PhelanDev/PHELAN_butterfly/Source code/wirring.jpg

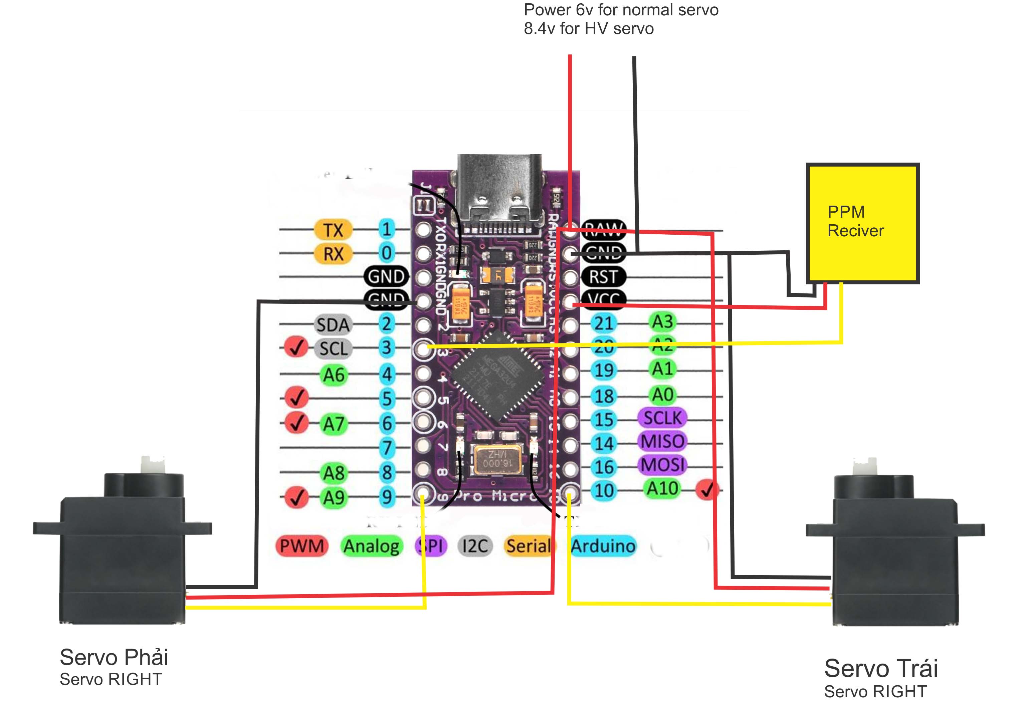
Source code/wirring.jpg
