PhelanDev/PHELAN_butterfly/sodomach/sodomach.png

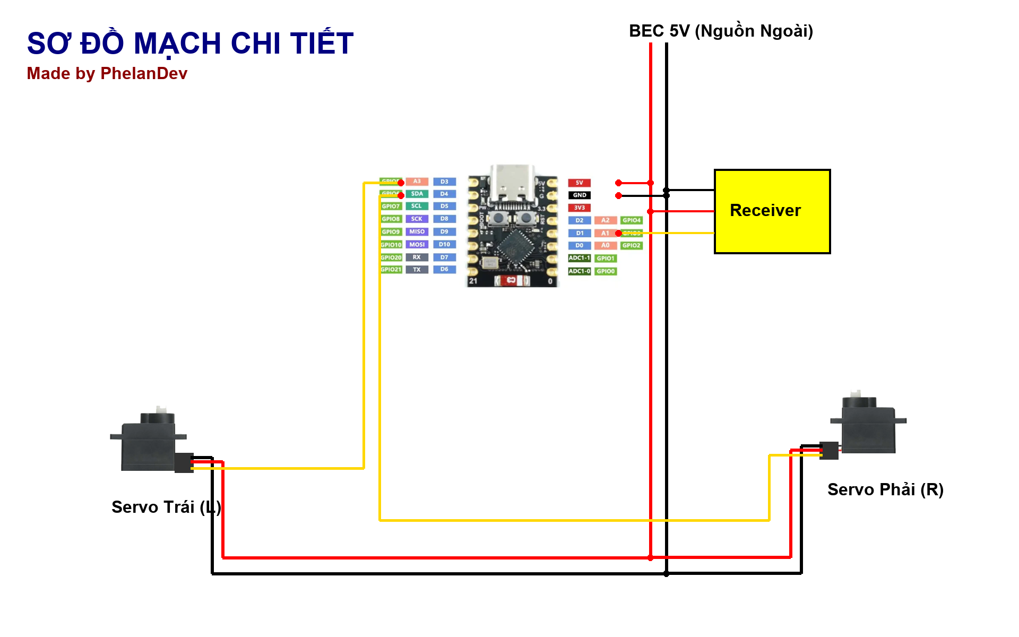
sodomach/sodomach.png
