PhelanDev/PHELAN_butterfly/Templates_ Cutting files/laser_cut_Main_fram_S_DiY_RC_bionic_butterfly.dxf

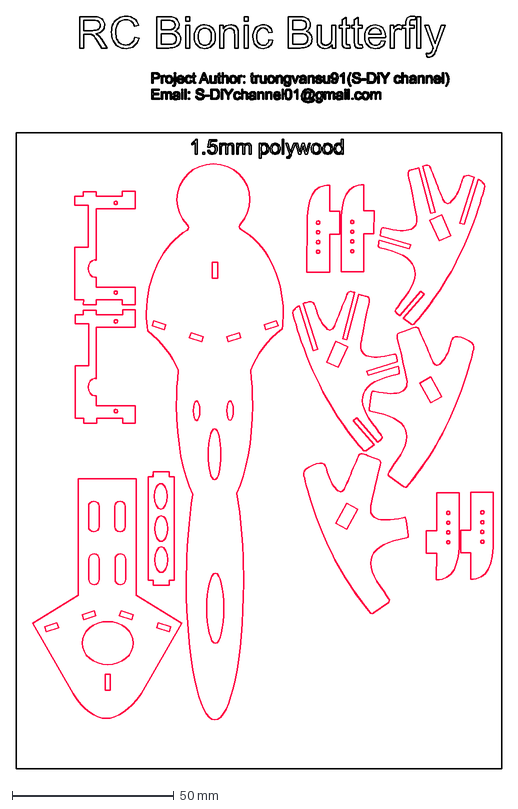
[picture p3: CAD file, 2026-07-16]
Templates_ Cutting files/laser_cut_Main_fram_S_DiY_RC_bionic_butterfly.dxf
150.3 x 232.9 mm
