PhelanDev/PHELAN_butterfly/khungcanh/01_Than_Chinh_Main_Body_Slim_Fillet.step

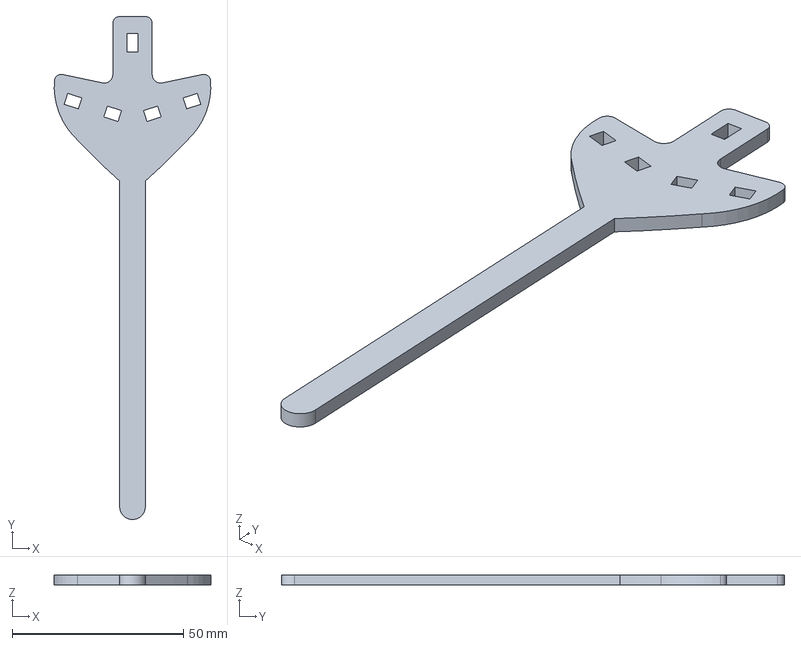
[picture p4: CAD file, 2026-09-27]
khungcanh/01_Than_Chinh_Main_Body_Slim_Fillet.step
45.7 x 146.8 x 3.00 mm
