PhelanDev/PHELAN_butterfly/khungcanh/Dimension_Main_fram.3d.dxf

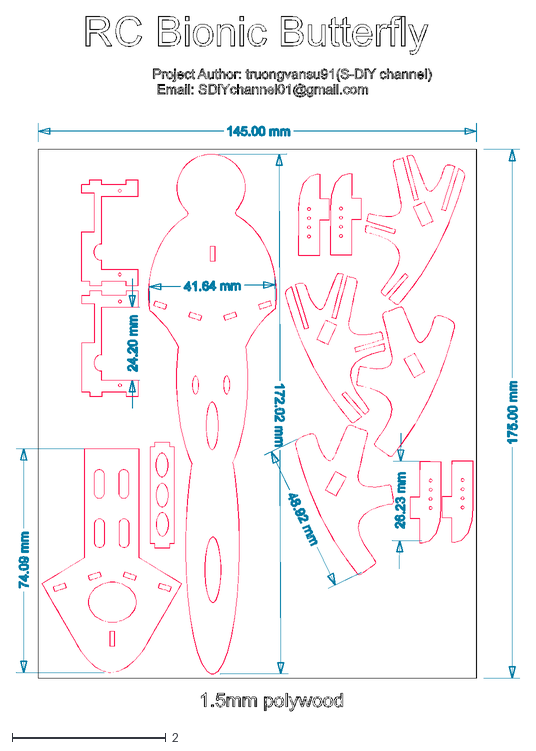
[picture p5: CAD file, 2026-09-27]
khungcanh/Dimension_Main_fram.3d.dxf
6.56 x 9.06
