PhelanDev/PHELAN_butterfly/khungcanh/04_Khung_Servo_Trai_PTK7452.step

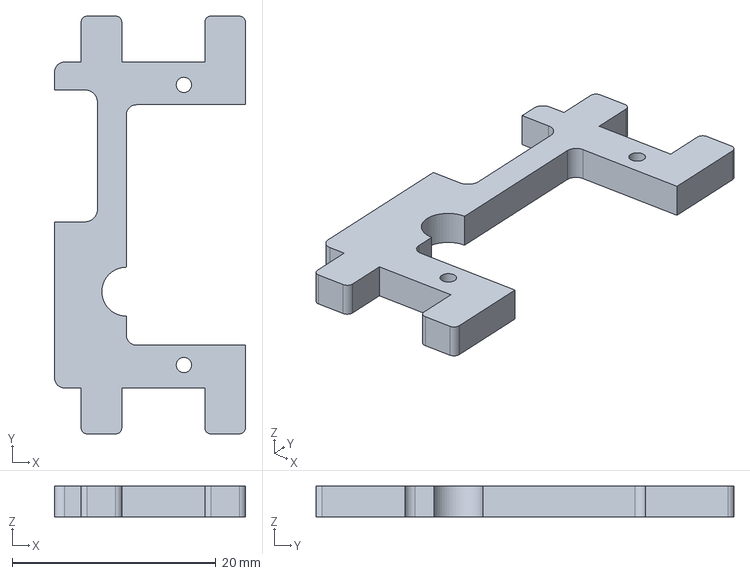
[picture p6: CAD file, 2026-09-27]
khungcanh/04_Khung_Servo_Trai_PTK7452.step
18.8 x 41.0 x 3.00 mm
