PhelanDev/PHELAN_butterfly/khungcanhmach/00_ALL_PARTS_FLAT_KHUNG_FELET-2.0.step

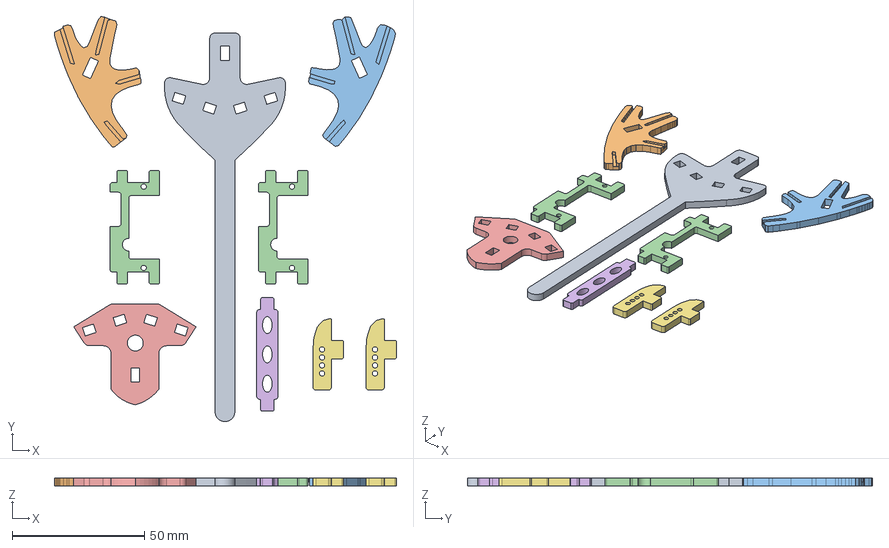
[picture p7: CAD file, 2026-10-04]
khungcanhmach/00_ALL_PARTS_FLAT_KHUNG_FELET-2.0.step
129.1 x 153.0 x 3.00 mm
