PhelanDev/PHELAN_butterfly/thanV3/01_Than_Lien_Khoi_Bionic_Pod_ESP32_C3_SuperMini_RealFit.step

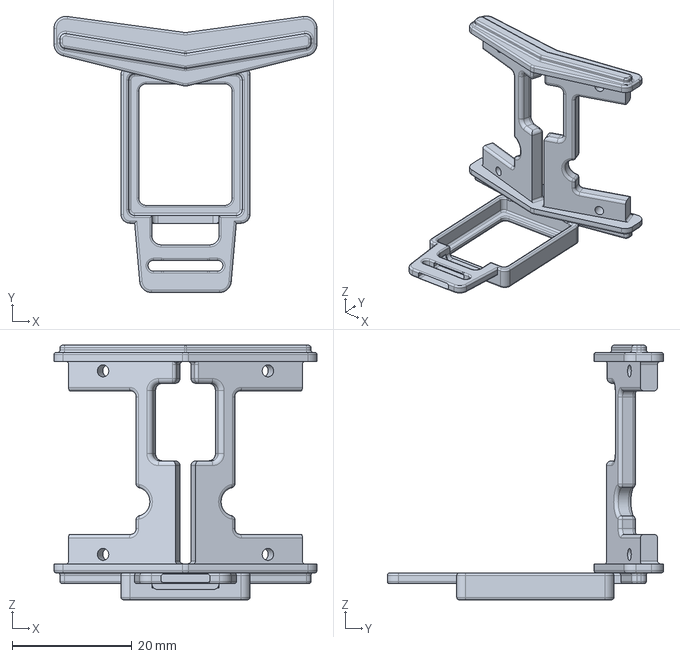
[picture p8: CAD file, 2026-10-15]
thanV3/01_Than_Lien_Khoi_Bionic_Pod_ESP32_C3_SuperMini_RealFit.step
44.0 x 46.2 x 42.6 mm
