PhelanDev/PHELAN_butterfly/khungcanh/08_Ban_Le_Truc_Xoay_x1.step

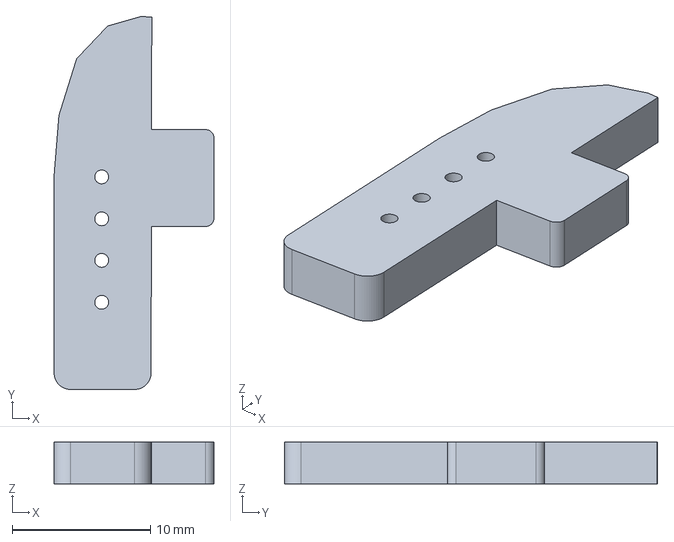
[picture p9: CAD file, 2026-09-27]
khungcanh/08_Ban_Le_Truc_Xoay_x1.step
11.5 x 26.9 x 3.00 mm
