PhelanDev/PHELAN_butterfly/khungcanhmach/03_Thanh_Giang_Bung_Center_Rib.step

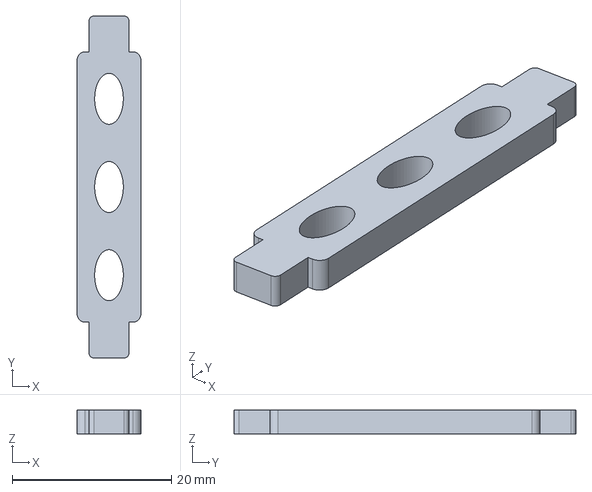
[picture p10: CAD file, 2026-10-04]
khungcanhmach/03_Thanh_Giang_Bung_Center_Rib.step
8.00 x 42.9 x 3.00 mm
