PhelanDev/PHELAN_butterfly/thanV3/01_Than_Lien_Khoi_Bionic_Pod_ESP32_BatteryRail.step

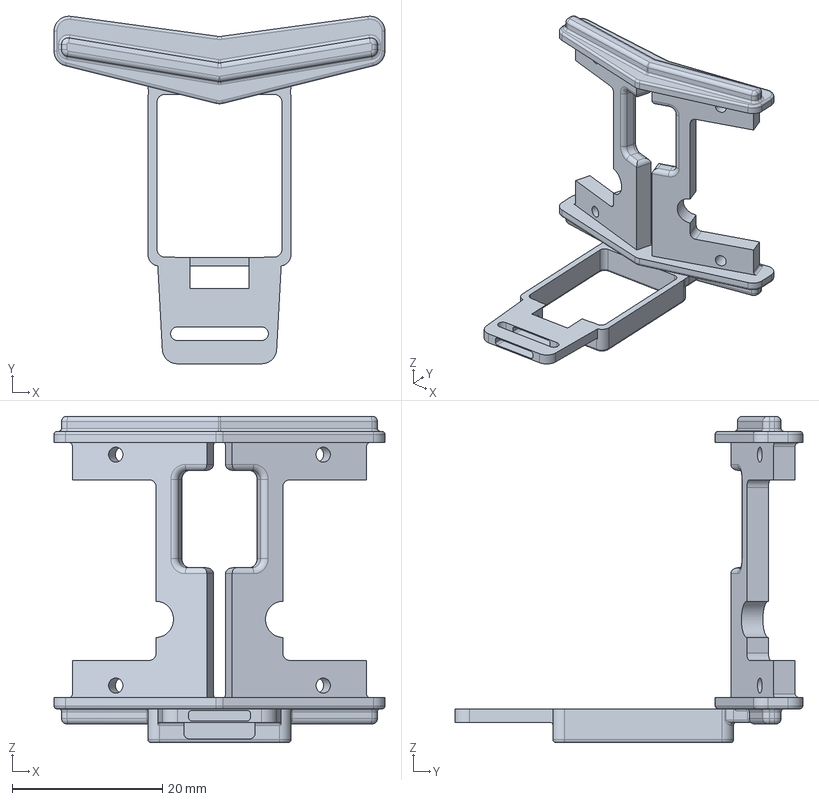
[picture p11: CAD file, 2026-10-15]
thanV3/01_Than_Lien_Khoi_Bionic_Pod_ESP32_BatteryRail.step
44.0 x 46.2 x 43.4 mm
