PhelanDev/PHELAN_butterfly/khungcanh/03_Thanh_Giang_Bung_Center_Rib.step

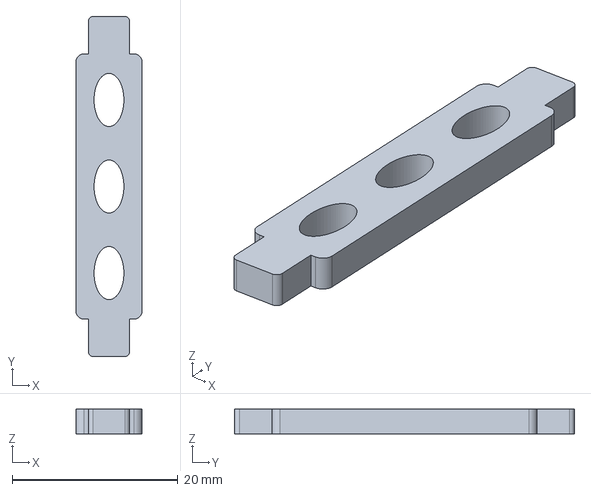
[picture p12: CAD file, 2026-09-27]
khungcanh/03_Thanh_Giang_Bung_Center_Rib.step
8.00 x 41.0 x 3.00 mm
