PhelanDev/PHELAN_butterfly/khungcanhmach/RC_Butterfly_All_Parts_Flat_PTK7452_PETG_3mm.step

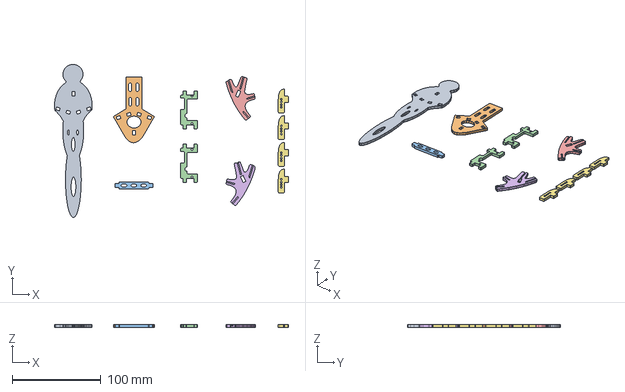
[picture p13: CAD file, 2026-10-04]
khungcanhmach/RC_Butterfly_All_Parts_Flat_PTK7452_PETG_3mm.step
262.9 x 172.0 x 3.00 mm
