PhelanDev/PHELAN_butterfly/khungcanh/02_Tam_De_Nguc_Bottom_Plate_Slim_Fillet.step

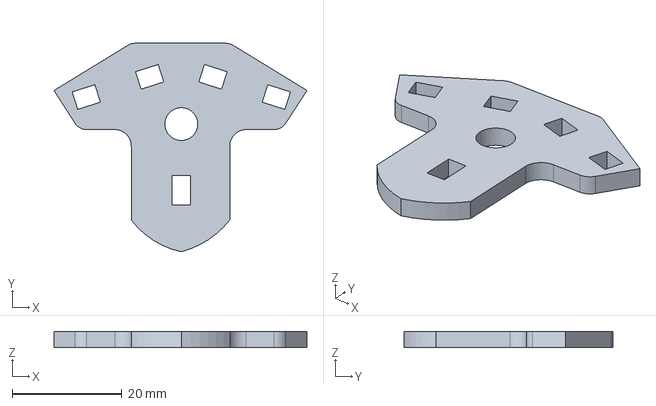
[picture p14: CAD file, 2026-09-27]
khungcanh/02_Tam_De_Nguc_Bottom_Plate_Slim_Fillet.step
46.2 x 38.1 x 3.00 mm
