PhelanDev/PHELAN_butterfly/khungcanhmach/06_Sung_Canh_Trai_Nguyen_Khoi_3mm.step

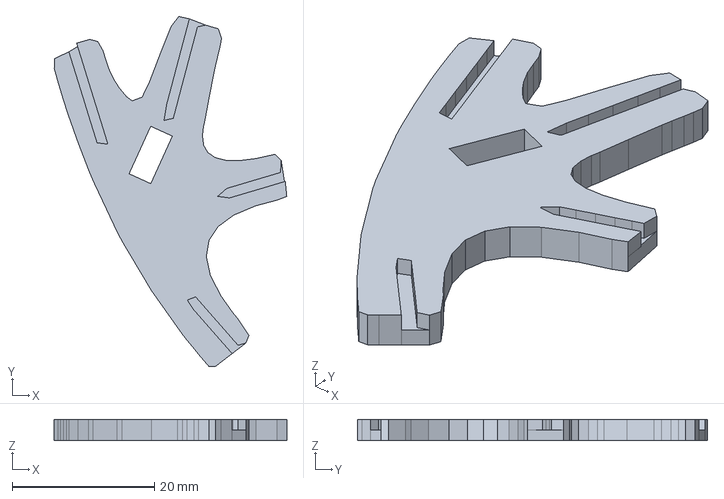
[picture p15: CAD file, 2026-09-27]
khungcanhmach/06_Sung_Canh_Trai_Nguyen_Khoi_3mm.step
32.7 x 49.3 x 3.00 mm
