PhelanDev/PHELAN_butterfly/khungcanhmach/09_Bo_2_Ban_Le_Truc_Xoay_x2.step

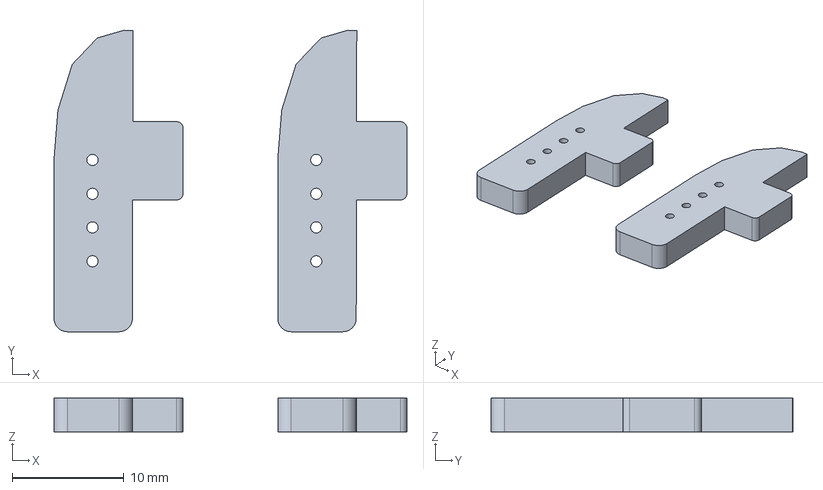
[picture p16: CAD file, 2026-09-27]
khungcanhmach/09_Bo_2_Ban_Le_Truc_Xoay_x2.step
31.6 x 26.9 x 3.00 mm
