PhelanDev/PHELAN_butterfly/thanV1/05_Khung_Servo_Phai_PTK7452.step

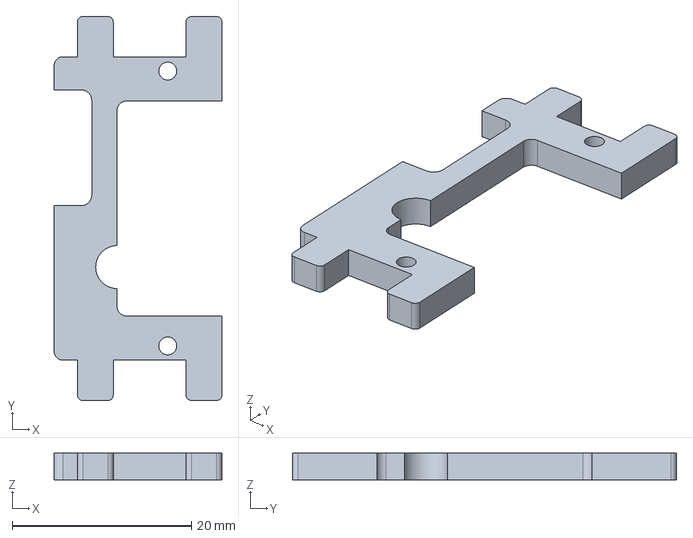
[picture p17: CAD file, 2026-10-06, an earlier design]
thanV1/05_Khung_Servo_Phai_PTK7452.step
18.8 x 42.9 x 3.00 mm
