PhelanDev/PHELAN_butterfly/thanV2/01_Than_Lien_Khoi_Micro_Butterfly_PTK7452_Reinforced.step

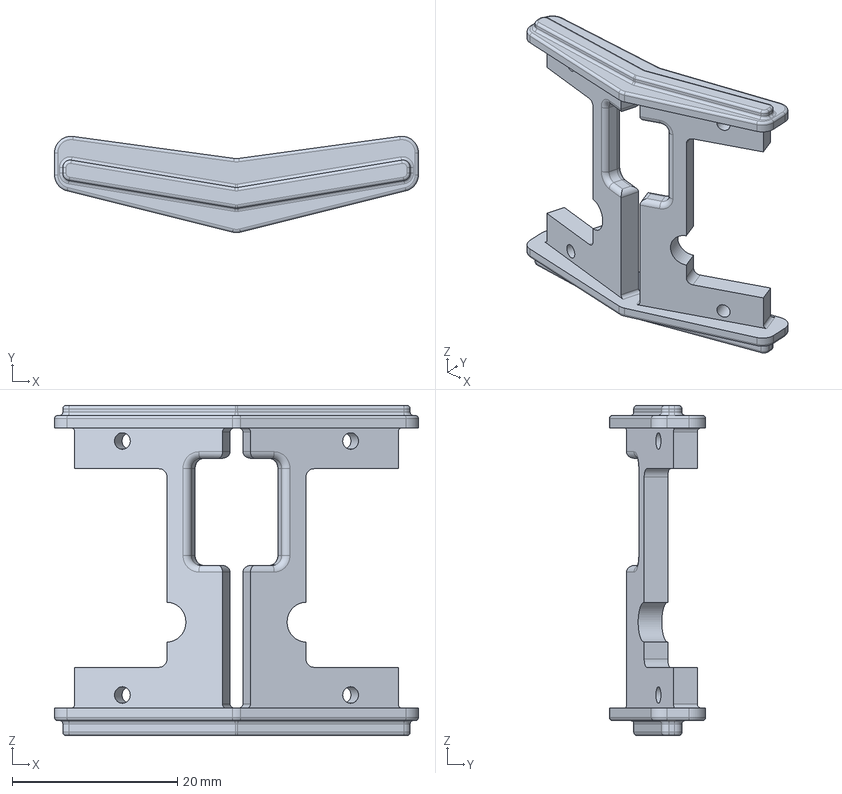
[picture p18: CAD file, 2026-10-15, an earlier design]
thanV2/01_Than_Lien_Khoi_Micro_Butterfly_PTK7452_Reinforced.step
44.0 x 11.6 x 39.9 mm
