PhelanDev/PHELAN_butterfly/(list of files, cad)

Other CAD files:
khungcanhmach/00_ALL_PARTS_FLAT_KHUNG_FELET.step
khungcanhmach/05_Khung_Servo_Phai_PTK7452.step
thanV1/04_Khung_Servo_Trai_PTK7452.step
thanV1/09_Bo_2_Ban_Le_Truc_Xoay_x2.step
thanV2/00_ALL_4_PARTS_FOR_WEIGHT_CHECK.step
thanV2/07_Sung_Canh_Phai_Nguyen_Khoi_3mm.step
thanV2/08_Ban_Le_Truc_Xoay_x1.step
