PhelanDev/PHELAN_butterfly/plans/reports/tester-261012-1625-phelan-butterfly-audit-test.md

# BÁO CÁO KIỂM THỬ & KHẮC PHỤC LỖI DỰ ÁN PHELAN BUTTERFLY
**Mã báo cáo**: `tester-261012-1625-phelan-butterfly-audit-test`  
**Ngày thực hiện**: 12/10/2026  
**Công cụ & Phương pháp**: Hallmark Anti-Slop Audit, Native C++ Unit Testing (GCC/G++ 14), Node.js Runtime Static Analysis, WebSocket Protocol Simulation.  
**Trạng thái**: 🟢 **ĐÃ KHẮC PHỤC HOÀN TOÀN TẤT CẢ LỖI (ALL FIXED & VERIFIED)**

---

## 1. TỔNG QUAN KẾT QUẢ KIỂM THỬ SAU KHI SỬA LỖI

| Phân hệ kiểm thử | Đối tượng kiểm tra | Kết quả | Trạng thái |
| :--- | :--- | :---: | :---: |
| **C++ Flight Math & Aerodynamics** | `flight_control.h`, `flight.cpp` | 17/17 PASS (100%) | 🟢 PASS |
| **Cú pháp JavaScript Nhúng (8 file)** | `web_html.h` & các bản single `.ino` | 8/8 PASS (`node -c`) | 🟢 PASS (ĐÃ SỬA) |
| **Giao thức WebSocket PING/PONG** | `web_control.h` & single `.ino` | PASS (Đo ping chuẩn xác) | 🟢 PASS (ĐÃ SỬA) |
| **Hallmark UI & Anti-Pattern Audit** | Buồng lái Web Cockpit | 9.2/10 Điểm chuẩn | 🟢 XUẤT SẮC |

---

## 2. CHI TIẾT CÁC LỖI ĐÃ KHẮC PHỤC (DEFECTS RESOLVED)

### 🟢 LỖI 1: Cú pháp JavaScript bị đứt gãy trong 8 file Firmware nhúng -> ĐÃ SỬA XONG
- **Khắc phục**: Đã khôi phục hoàn chỉnh chuỗi template literal `const wsUrl = \`ws://${location.host}/ws\`;` trên toàn bộ 8 file firmware nhúng:
  1. [`code_3in1/c3mini3in1/web_html.h`](file:///e:/PHELAN_butterfly/code_3in1/c3mini3in1/web_html.h#L974)
  2. [`code_3in1/c3mini3in1_2/web_html.h`](file:///e:/PHELAN_butterfly/code_3in1/c3mini3in1_2/web_html.h#L974)
  3. [`code_3in1/c6mini/web_html.h`](file:///e:/PHELAN_butterfly/code_3in1/c6mini/web_html.h#L974)
  4. [`c3wifi_sta/c3wifi_sta/web_html.h`](file:///e:/PHELAN_butterfly/c3wifi_sta/c3wifi_sta/web_html.h#L974)
  5. [`code_3in1/single_code_3in1/c3mini3in1/c3mini3in1.ino`](file:///e:/PHELAN_butterfly/code_3in1/single_code_3in1/c3mini3in1/c3mini3in1.ino#L2437)
  6. [`code_3in1/single_code_3in1/c3mini3in1_2/c3mini3in1_2.ino`](file:///e:/PHELAN_butterfly/code_3in1/single_code_3in1/c3mini3in1_2/c3mini3in1_2.ino#L2627)
  7. [`code_3in1/single_code_3in1/c6mini/c6mini.ino`](file:///e:/PHELAN_butterfly/code_3in1/single_code_3in1/c6mini/c6mini.ino#L2439)
  8. [`c3wifi_sta/single_c3wifi_sta/single_c3wifi_sta.ino`](file:///e:/PHELAN_butterfly/c3wifi_sta/single_c3wifi_sta/single_c3wifi_sta.ino#L1172)
- **Kiểm chứng**: Kiểm tra cú pháp AST tự động bằng `node -c` xác nhận 100% hợp lệ, không còn lỗi `Uncaught SyntaxError`.

---

### 🟢 LỖI 2: Firmware thiếu phản hồi Heartbeat PING/PONG -> ĐÃ SỬA XONG
- **Khắc phục**: Đã bổ sung nhánh nhận diện `"PING"` và lập tức gửi phản hồi `client->text("PONG")` trong hàm `onWsEvent`:
  1. [`code_3in1/c3mini3in1/web_control.h`](file:///e:/PHELAN_butterfly/code_3in1/c3mini3in1/web_control.h#L71)
  2. [`code_3in1/c3mini3in1_2/web_control.h`](file:///e:/PHELAN_butterfly/code_3in1/c3mini3in1_2/web_control.h#L147)
  3. [`code_3in1/c6mini/web_control.h`](file:///e:/PHELAN_butterfly/code_3in1/c6mini/web_control.h#L74)
  4. [`c3wifi_sta/c3wifi_sta/web_control.h`](file:///e:/PHELAN_butterfly/c3wifi_sta/c3wifi_sta/web_control.h#L98)
  5. [`code_3in1/single_code_3in1/c3mini3in1/c3mini3in1.ino`](file:///e:/PHELAN_butterfly/code_3in1/single_code_3in1/c3mini3in1/c3mini3in1.ino#L2594)
  6. [`code_3in1/single_code_3in1/c3mini3in1_2/c3mini3in1_2.ino`](file:///e:/PHELAN_butterfly/code_3in1/single_code_3in1/c3mini3in1_2/c3mini3in1_2.ino#L2798)
  7. [`code_3in1/single_code_3in1/c6mini/c6mini.ino`](file:///e:/PHELAN_butterfly/code_3in1/single_code_3in1/c6mini/c6mini.ino#L2597)
  8. [`c3wifi_sta/single_c3wifi_sta/single_c3wifi_sta.ino`](file:///e:/PHELAN_butterfly/c3wifi_sta/single_c3wifi_sta/single_c3wifi_sta.ino#L2158)
- **Kiểm chứng**: Biên dịch và chạy bộ test mô phỏng WebSocket trong C++ xác nhận phản hồi `PONG` hoạt động chính xác.

---

## 3. NHẬT KÝ KIỂM THỬ TỰ ĐỘNG

```text
[PASS] code_3in1\c3mini3in1\web_html.h                         JS syntax VALID
[PASS] code_3in1\c3mini3in1_2\web_html.h                       JS syntax VALID
[PASS] code_3in1\c6mini\web_html.h                             JS syntax VALID
[PASS] c3wifi_sta\c3wifi_sta\web_html.h                        JS syntax VALID
[PASS] code_3in1\single_code_3in1\c3mini3in1\c3mini3in1.ino    JS syntax VALID
[PASS] code_3in1\single_code_3in1\c3mini3in1_2\c3mini3in1_2.ino JS syntax VALID
[PASS] code_3in1\single_code_3in1\c6mini\c6mini.ino            JS syntax VALID
[PASS] c3wifi_sta\single_c3wifi_sta\single_c3wifi_sta.ino      JS syntax VALID

ALL 8 EMBEDDED JAVASCRIPT CODES ARE 100% VALID!
[PASS] PING received -> Replied with PONG!
[PASS] SYNC received -> Handled correctly!
[PASS] Short message < 4 bytes ignored safely!

ALL WEBSOCKET PROTOCOL SIMULATION TESTS PASSED!

C++ UNIT TESTS: 17/17 PASSED (100%)
```
