PhelanDev/PHELAN_butterfly/khungcanh/Dimension_A1_print_Phelan_butterfly_80cm_Bionic_Pod_3D.pdf

# Phelan Butterfly

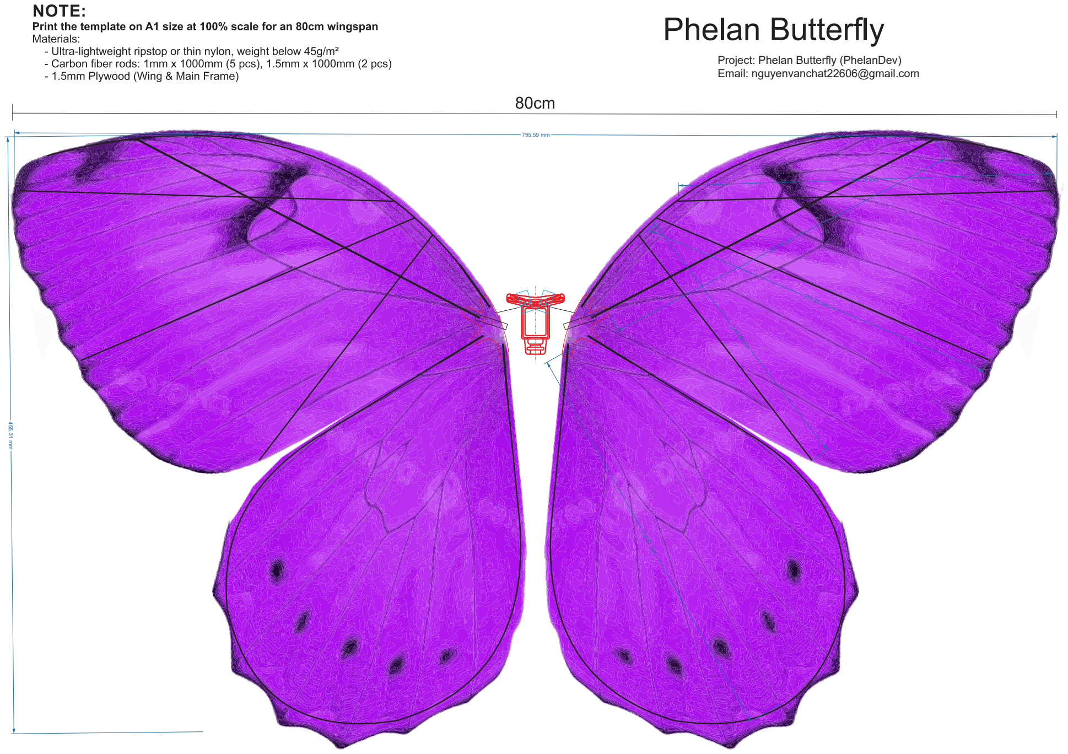
[picture p19: page 1]

Project: Phelan Butterfly (PhelanDev)
Email: nguyenvanchat22606@gmail.com
