PhelanDev/PHELAN_butterfly/Templates_ Cutting files/A1_print_S_DiY_ bionic_butterfly_ 80cm_logo.pdf

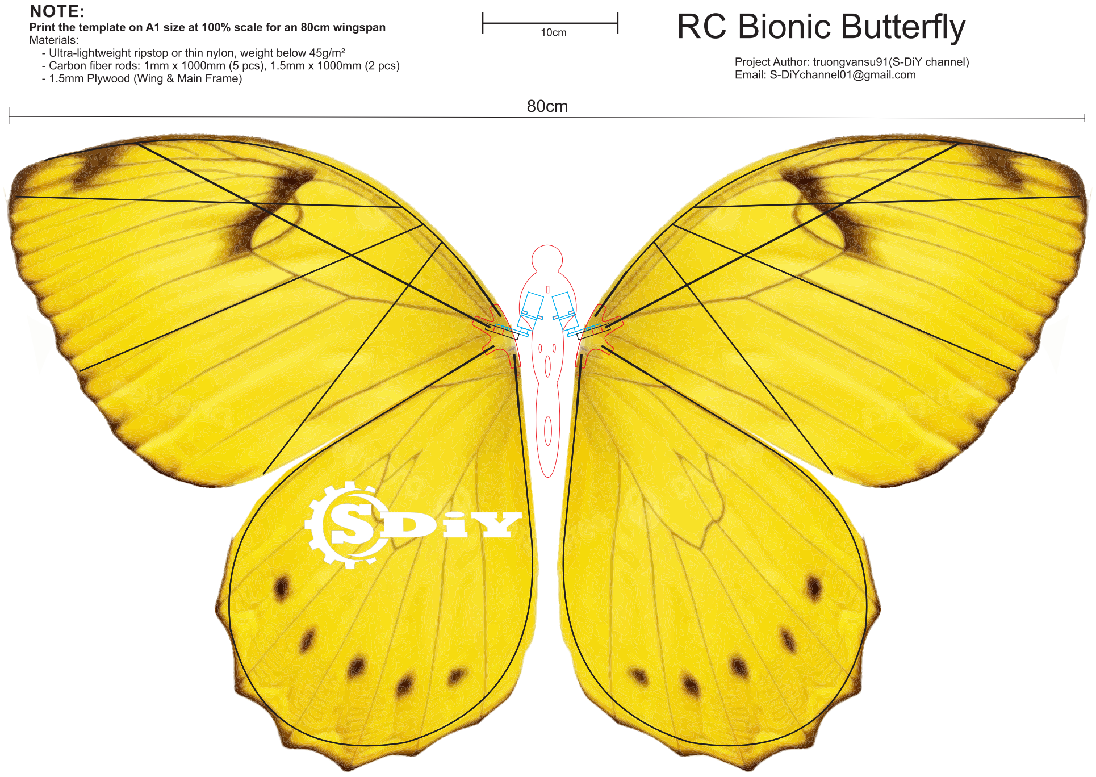
[picture p20: page 1]
