PhelanDev/PHELAN_butterfly/Templates_ Cutting files/Dimension_A1_print_S_DiY_ bionic_butterfly_ 80cm.pdf

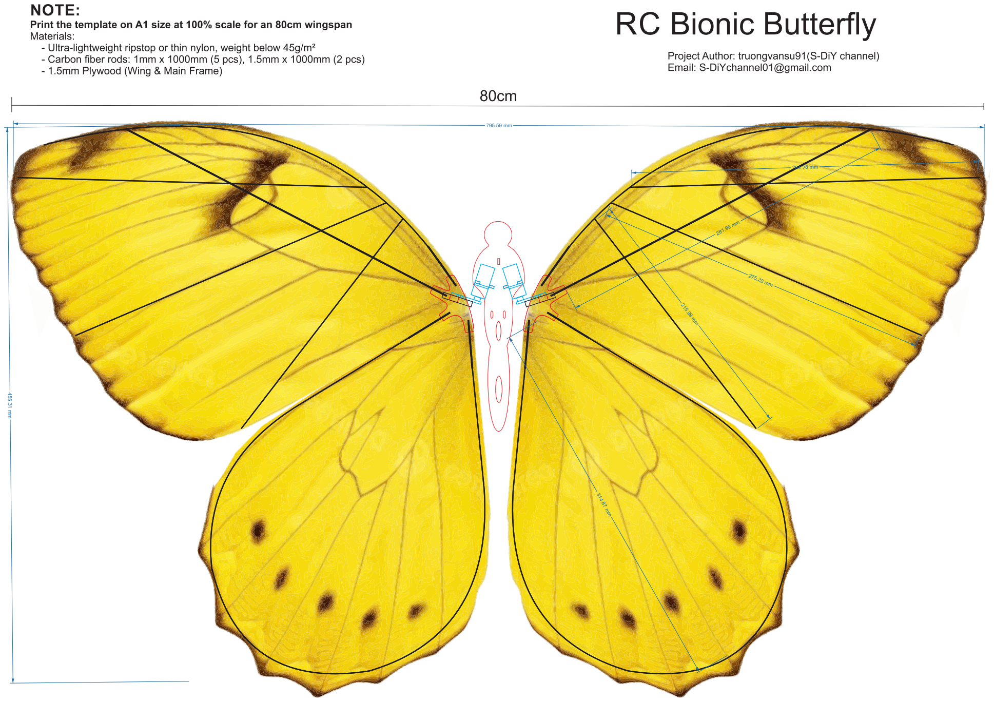
[picture p21: page 1]
