PhelanDev/PHELAN_butterfly/Templates_ Cutting files/Dimension_Main_fram.pdf

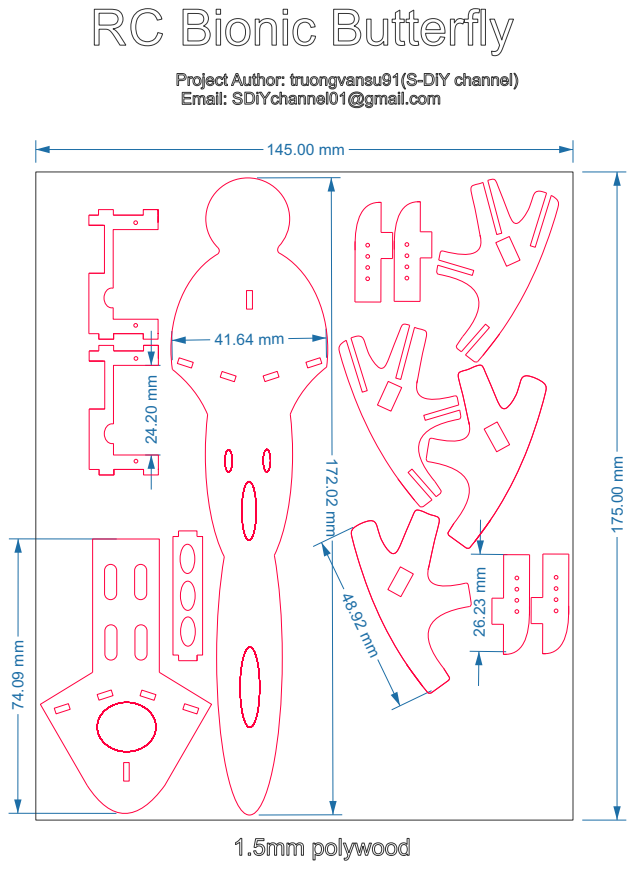
[picture p22: page 1]
