PhelanDev/PHELAN_butterfly/(commit log)

2026-09-27 feat(cad): add modular 3D STEP frame models and update frame mechanical parts
2026-09-27 refactor(hardware): rename khungcanh directory to khungcanhmach for PCB and mechanical assets
2026-09-27 fix(web): drop websocket frames when bufferedAmount > 0 to prevent network buffer bloat
2026-09-27 refactor(network): decouple UDP telemetry transmission from 300Hz flight loop to 50Hz background timer
2026-09-27 feat(rtos): isolate 300Hz flight control into dedicated FreeRTOS task with lock-free atomic snapshot
2026-09-27 refactor(rtos): delegate servo hardware control and state machine exclusively to flightCoreTask, ignore His.md
2026-09-27 docs(pinout): update power supply specifications to 2S LiPo with 5V BEC in README
2026-10-04 chore(khungcanhmach): update CAD STEP models and dimension drawing
2026-10-06 refactor(cad): reorganize CAD models into thanV1, thanV2, khungcanh, and sodomach
2026-10-12 fix(firmware): remove OLED completely and fix 5 critical flight & system bugs
    - Remove OLED completely: delete display_oled.h, USE_OLED macros, Wire, Adafruit libraries, DisplayTelemetry struct, and FreeRTOS display tasks
    - Introduce sys_monitor.h: lightweight CPU temp, freq, and uptime telemetry with ESP-IDF v5 sensor support
    - Fix early brownout detection: add early disable_bod_early() constructor across all 12 firmware targets
    - Fix dynamicAmp in phase resync: calculate dynamic amplitude first before phaseNeedsResync and scale with dynamicAmp instead of fixed FLAP_AMP
    - Standardize runtime BOD disable in setup() across modular and single .ino files
    - Maintain 100% logic and structura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
2026-10-12 update sau kiểm thử
2026-10-13 fix(firmware): harden serial time sync, rc channel parsing, and post-filter servo bounds
2026-10-14 fix(web): decode PERCH flag 0x04 to activate perching mode on idle throttle
2026-10-14 fix(bridge): isolate servo detachment to flightCoreTask via kill snapshot in c3mini3in1_2
2026-10-14 fix(build): rename sin .ino files to match parent directories for Arduino IDE compliance
2026-10-14 fix(firmware): add PERCH exit pulse on web GCS and initialize watchdog early
    - Add PERCH Exit Pulse (1750us) in onWsEvent when Perch button is released on idle throttle without pitch input across all 8 Web GCS firmware
    - Prevent FSM from remaining stuck in PERCHING mode due to mechanical hysteresis [1100, 1700]us, smoothly returning wings to flat glide (1500us)
    - Reset wasWebPerchActive state on WebSocket client disconnection
    - Move setupWatchdog() to early setup() right after reset reason on c3mini3in1_2 and c3wifi_sta (modular and single) to eliminate FreeRTOS race conditions
    - Fully synchronized across all 10 firmware targets
2026-10-15 feat(cad): add thanV2/thanV3 CAD models and update bionic pod drawing
2026-10-25 feat(servo): drive servos in microseconds with float targets and 3us deadband
2026-10-25 refactor(rtos): run RC filtering and kill switch inside 3ms flight task
2026-10-25 refactor(multi-file): port RTOS, telemetry, servo-us and waveform changes from single builds
2026-10-26 fix(rtos): resolve RTOS mutex safety, UART reconfiguration, lock-free telemetry and WDT
2026-10-26 fix(rc): fix CRSF sync recovery, SBUS2 footer, symmetric EMA and instant kill switch
2026-10-26 fix(flight): fix glide flap direction, triangle phase logic, servo EMA, trim mapping and perch range
2026-10-26 test: update extracted_config with compile-time servo limits
2026-10-26 test: add test suite for 4 edge case firmware bugs
2026-10-26 fix(single): resolve 4 edge-case bugs on single triangle and sine builds
2026-10-26 fix(modular): sync 4 edge-case bugfixes to modular triangle and sine builds
2026-10-26 fix(single): decouple rc ema filtering from flight loop to packet arrival
2026-10-26 fix(modular): decouple rc ema filtering from flight loop to packet arrival
