PhelanDev/PHELAN_butterfly/(notices)

Notices in the files:
README.md:
License: Proprietary
